ABErlich/LaboDeMicros/doc/otros/Fotos/IMG_20181115_192214.jpg

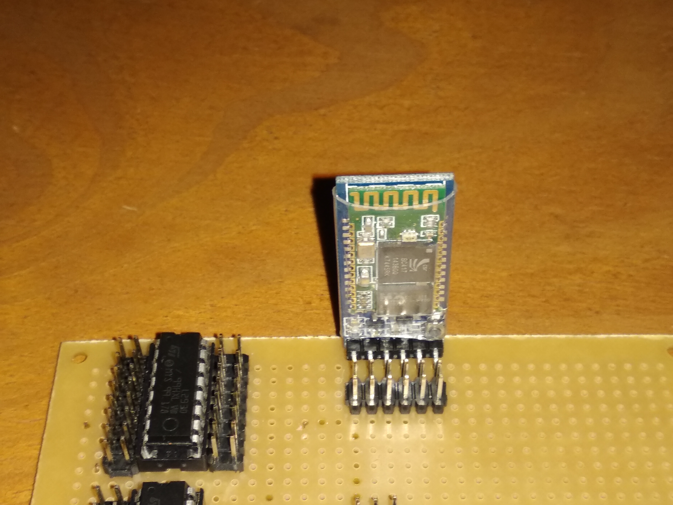
doc/otros/Fotos/IMG_20181115_192214.jpg
