ABErlich/LaboDeMicros/doc/anteproyecto/imagen_ilustrativa.jpg

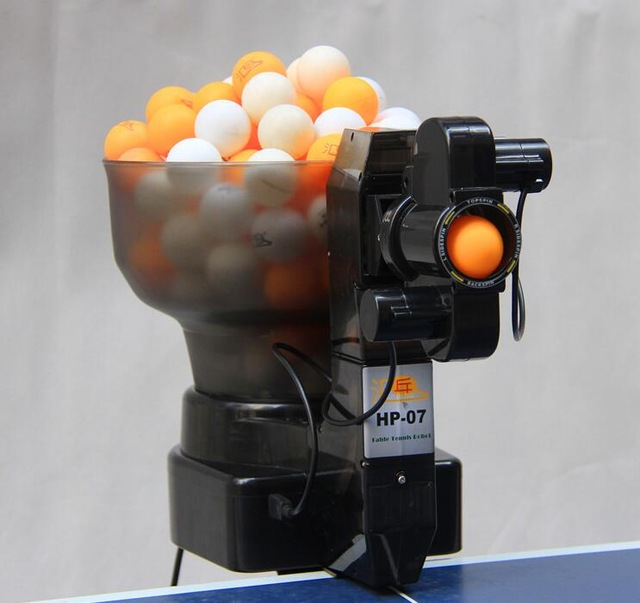
doc/anteproyecto/imagen_ilustrativa.jpg
