ABErlich/LaboDeMicros/README.md

Repositorio para la documentación de proyectos de
6609/8607 Laboratorio de Microcontroladores

<h3><b>Integrantes:</b></h3>
<ul>
  <li>Axel Erlich, 94847</li>
</ul>

<span>
  <b>iRoboPong5000, lo último en robots lanzadores de pelotas para jugadores de alto rendimiento.</b>
  
  iRoboPong5000 es el compañero perfecto para las sesiones de entrenamiento focalizadas en mejorar la tecnica del golpe, iRoboPong5000 te   permitirá tener una alimentación continua de pelotitas para que el jugador solo se enfoque en el ejercicio.
  
  Al regular la velocidad, profundidad y efecto de la pelotita a lanzar, se pueden lograr ejercicios dinámicos de distribución de pelota y   movimiento.
  El control del robot es completamente inhalambrico desde su smartphone. Tan solo debera encenderlo, cargarle pelotitas y estará listo    para jugar.
  
</span>
