ABErlich/LaboDeMicros/doc/diagramas/flujoModoAutomatico.png

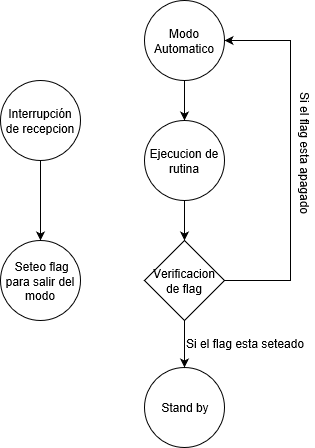
doc/diagramas/flujoModoAutomatico.png
