ABErlich/LaboDeMicros/doc/otros/MapeoPines2560Arduino.png

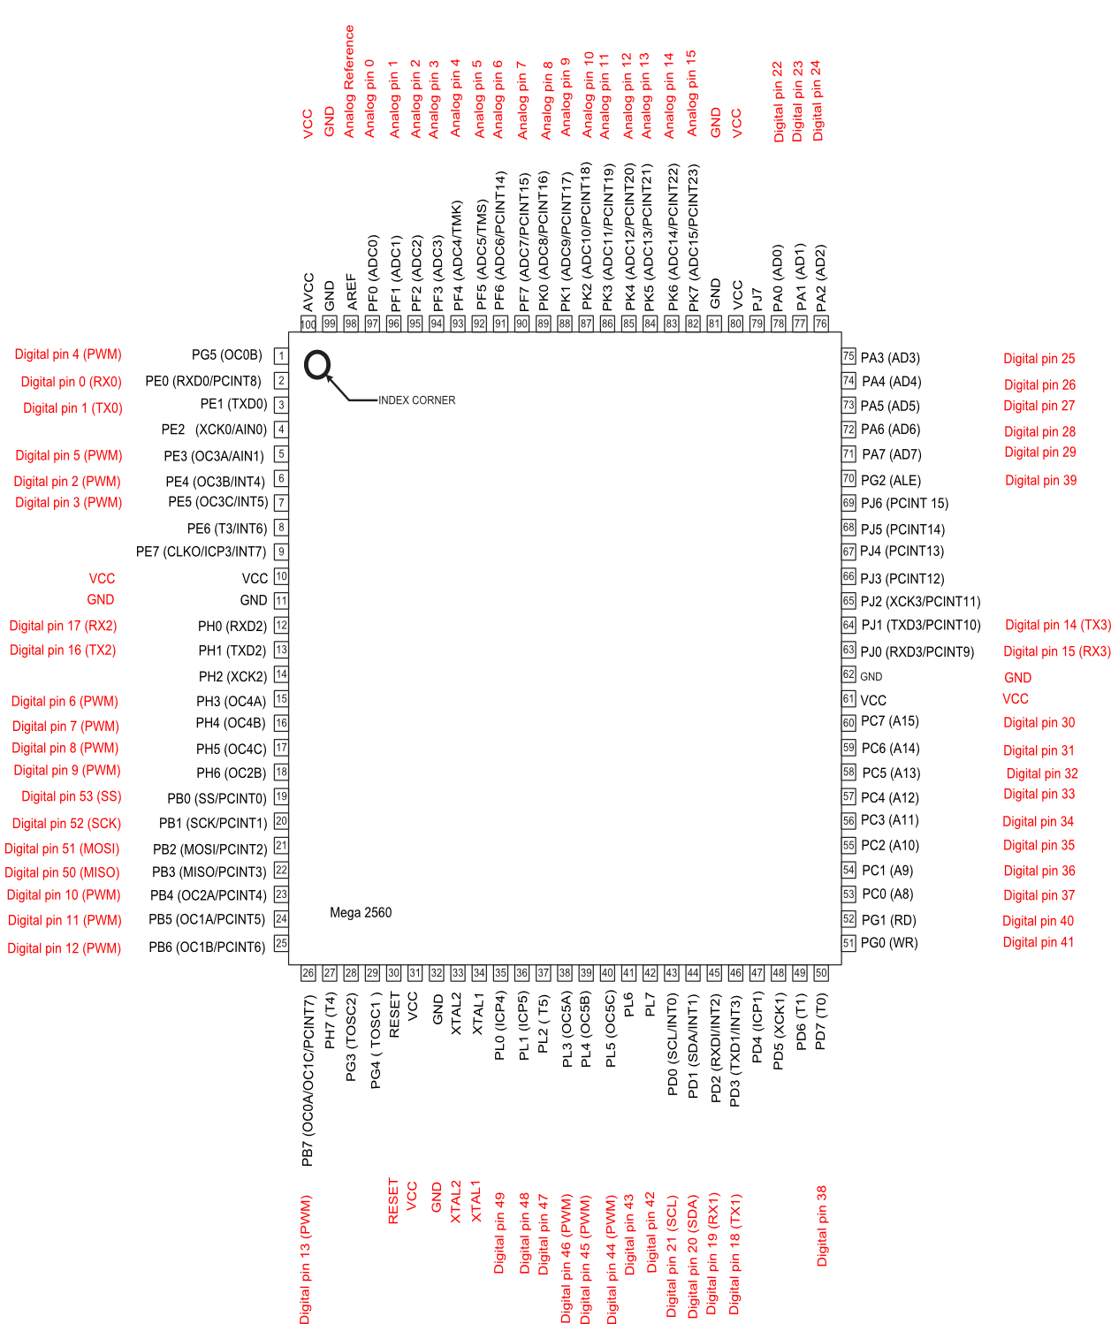
doc/otros/MapeoPines2560Arduino.png
