ABErlich/LaboDeMicros/doc/diagramas/Schematic_New-Project_Sheet-1_20181129231422.pdf

Input | Output

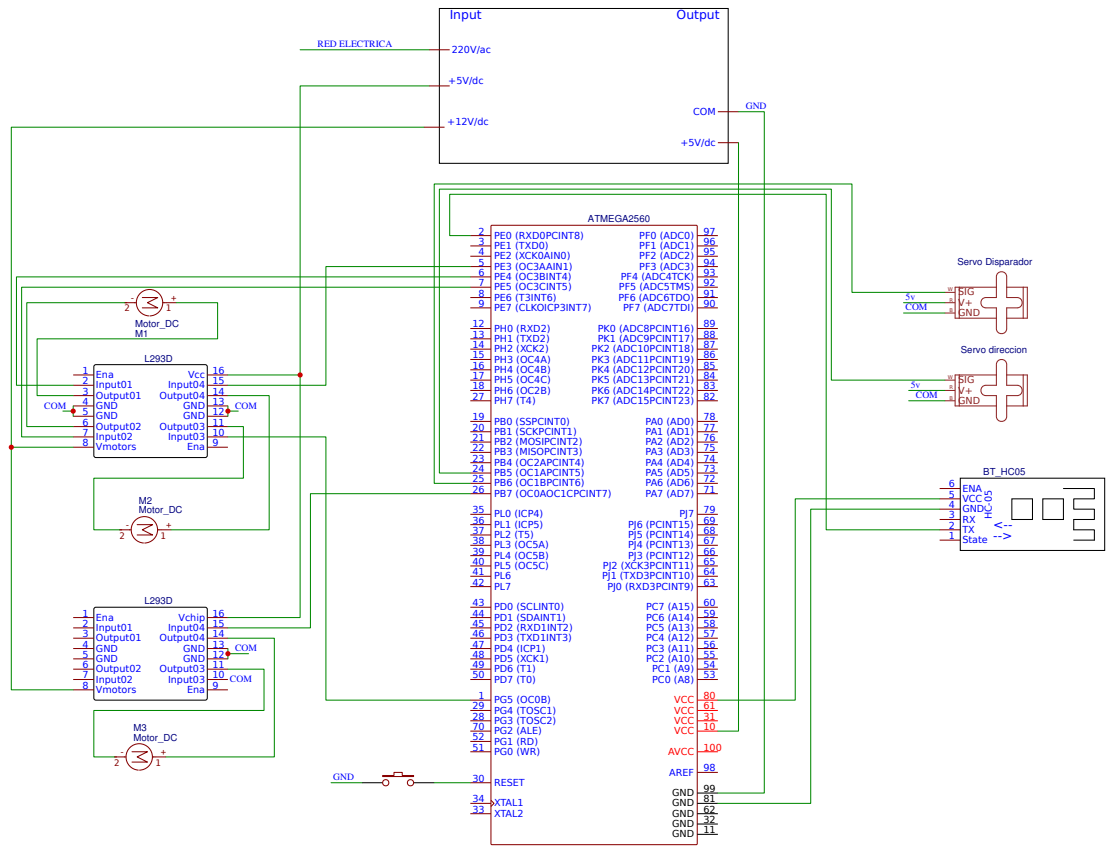
[picture p37: page 1]
ATMEGA2560; PJ0 (RXD3PCINT9) 63; AVCC 100; VCC 31; GND 11 GND 32; GND 81; PD2 (RXD1INT2) 45; RESET 30; VCC 80; XTAL1 34; PJ5 (PCINT14) 68 PJ6 (PCINT15) 69; AREF 98; PD1 (SDAINT1) 44; PB6 (OC1BPCINT6) 25; PD3 (TXD1INT3) 46 PD4 (ICP1) 47 PD5 (XCK1) 48 PD6 (T1) 49 PD7 (T0) 50; PF1 (ADC1) 96 PF2 (ADC2) 95; PF4 (ADC4TCK) 93 PF5 (ADC5TMS) 92 PF6 (ADC6TDO) 91 PF7 (ADC7TDI) 90; PG0 (WR) 51 PG1 (RD) 52 PG2 (ALE) 70; PD0 (SCLINT0) 43; PH2 (XCK2) 14; VCC 10; XTAL2 33; PG3 (TOSC2) 28; PB5 (OC1APCINT5) 24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

9 Input03 10 Output03 11 GND 12 GND 13 Output04 14 Input04 15 Vcc 16

5 ENA 6
VCC
1 TX 2 RX 3 GND 4

9 Input03 10 Output03 11 GND 12 GND 13 Output04 14 Input04 15 Vchip 16
