ABErlich/LaboDeMicros/doc/diagramas/Diagrama en bloques.pdf

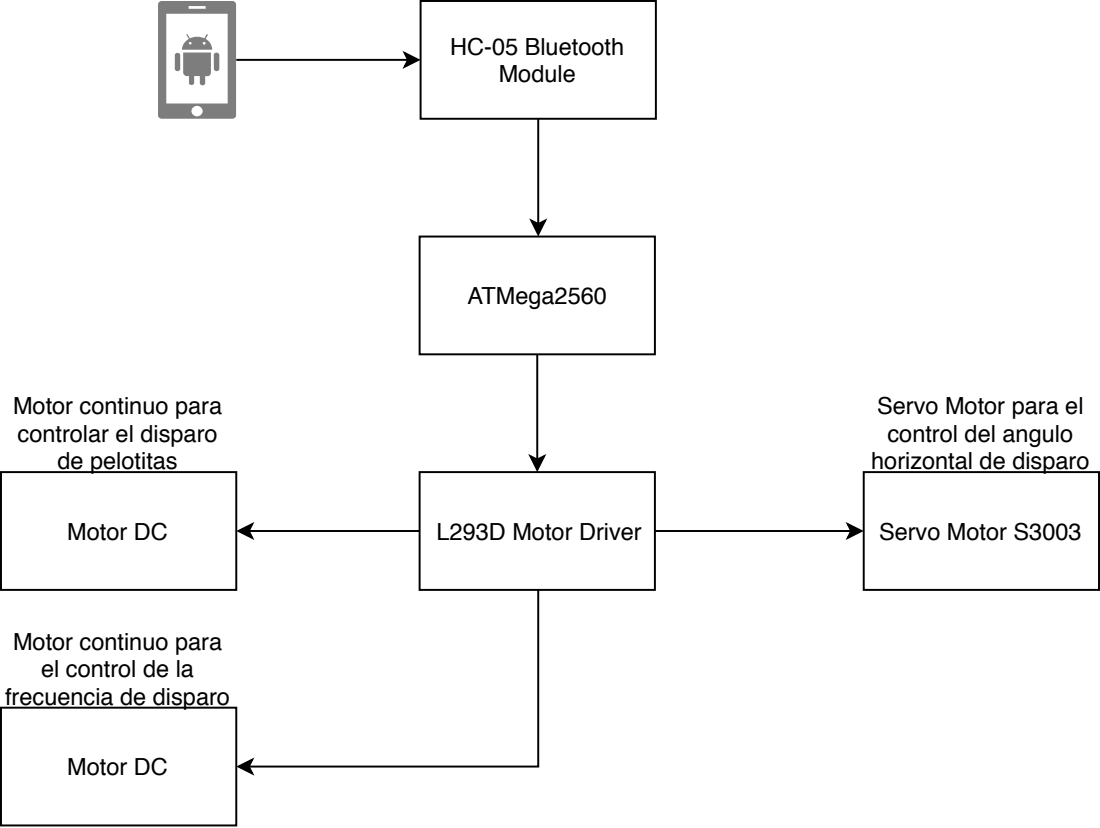
[picture p38: page 1]
ATMega2560; L293D Motor Driver; HC-05 Bluetooth Module; Servo Motor S3003; Motor DC

Motor continuo para
controlar el disparo
de pelotitas

Servo Motor para el
control del angulo
horizontal de disparo

el control de la
frecuencia de disparo
