ABErlich/LaboDeMicros/doc/diagramas/Diagrama de estados.pdf

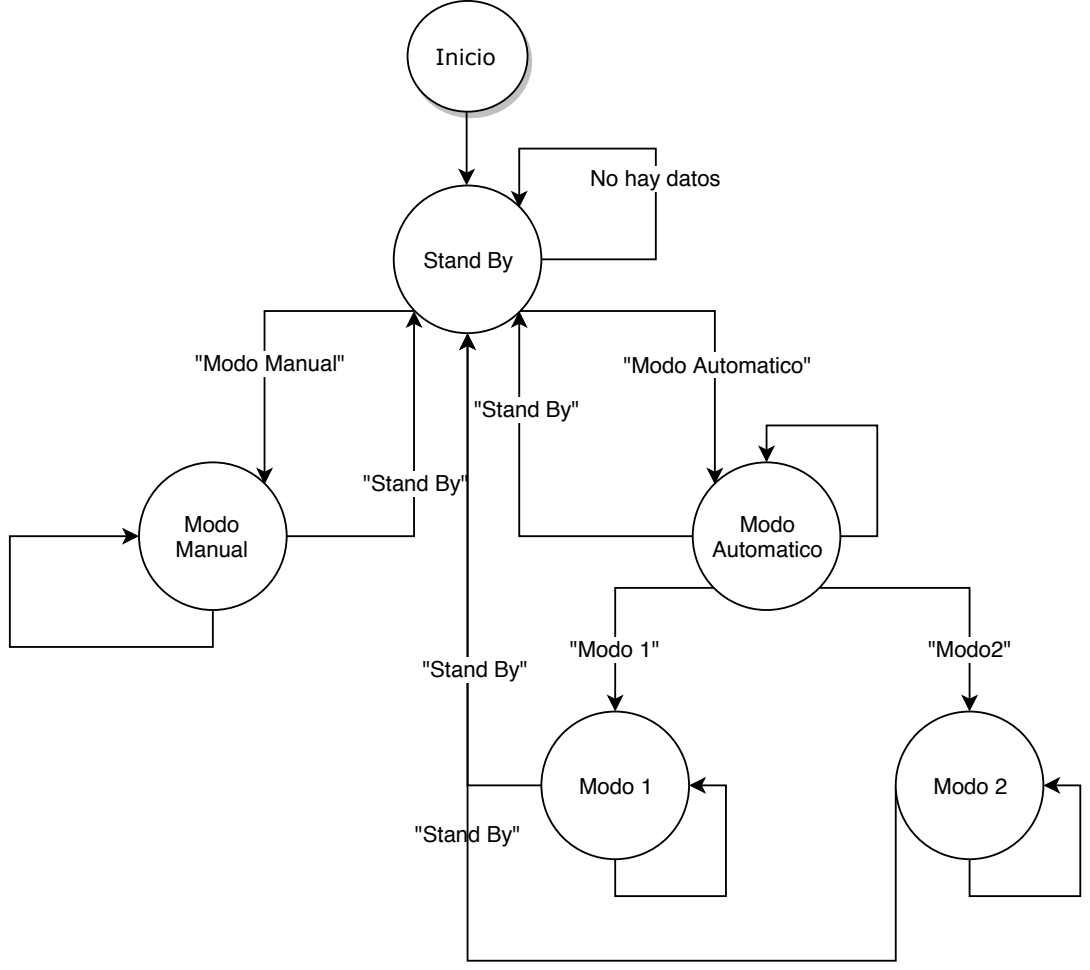
[picture p39: page 1]
Inicio; "Modo Manual"; "Modo Automatico"; Stand By; "Stand By"; Modo Manual; "Modo 1"; "Modo2"; Modo Automatico; Modo 1; Modo 2

No hay datos
