ABErlich/LaboDeMicros/(commit log)

2018-09-06 Agrega proyecto para prender led
2018-09-06 Agrego un archivo de referencias
2018-09-06 Subo el set de instrucciones
2018-09-12 Agrega otro proyecto de ejemplo
2018-09-13 Agrega el tema de las resistencias de pullup
2018-10-04 Agrego informacion sobre manejo de vectores en RAM y FLASH
2018-10-09 Subo varios ejercicios de parcial que fui haciendo
2018-10-09 Agrego ejercicios de lectura/escritura a ROM
2019-02-22 Cargo el proyecto entero en mi repo publico
